ghostintranslation/motherboard/hardware/motherboard-1.WEBP

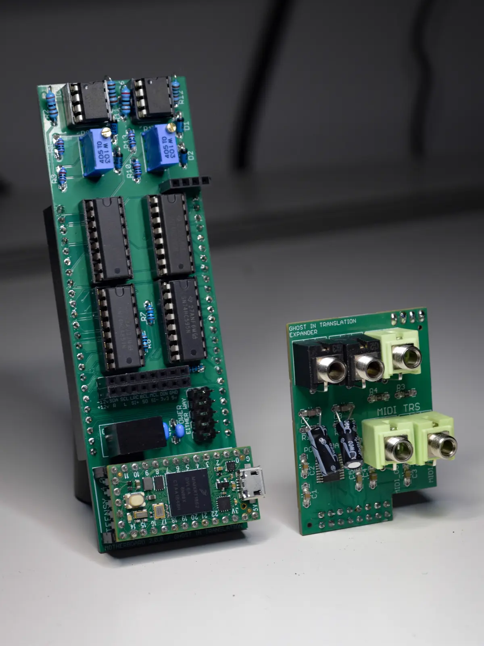
hardware/motherboard-1.WEBP
