ghostintranslation/motherboard/hardware/motherboard-2.WEBP

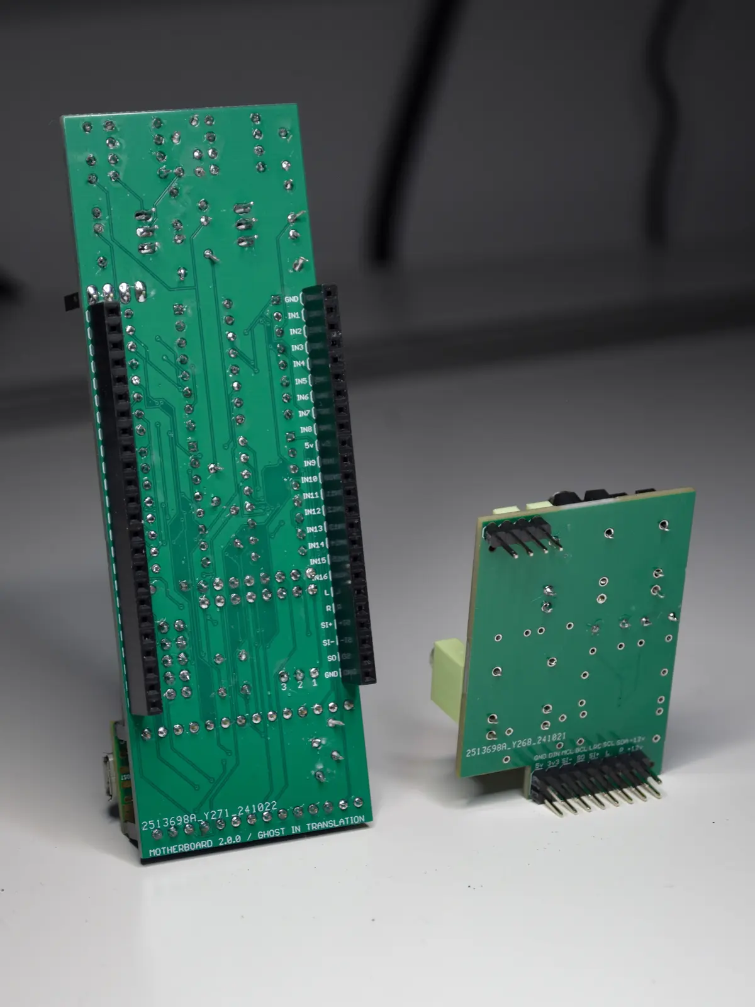
hardware/motherboard-2.WEBP
