ghostintranslation/motherboard/hardware/One_1-0-0_schematic.png

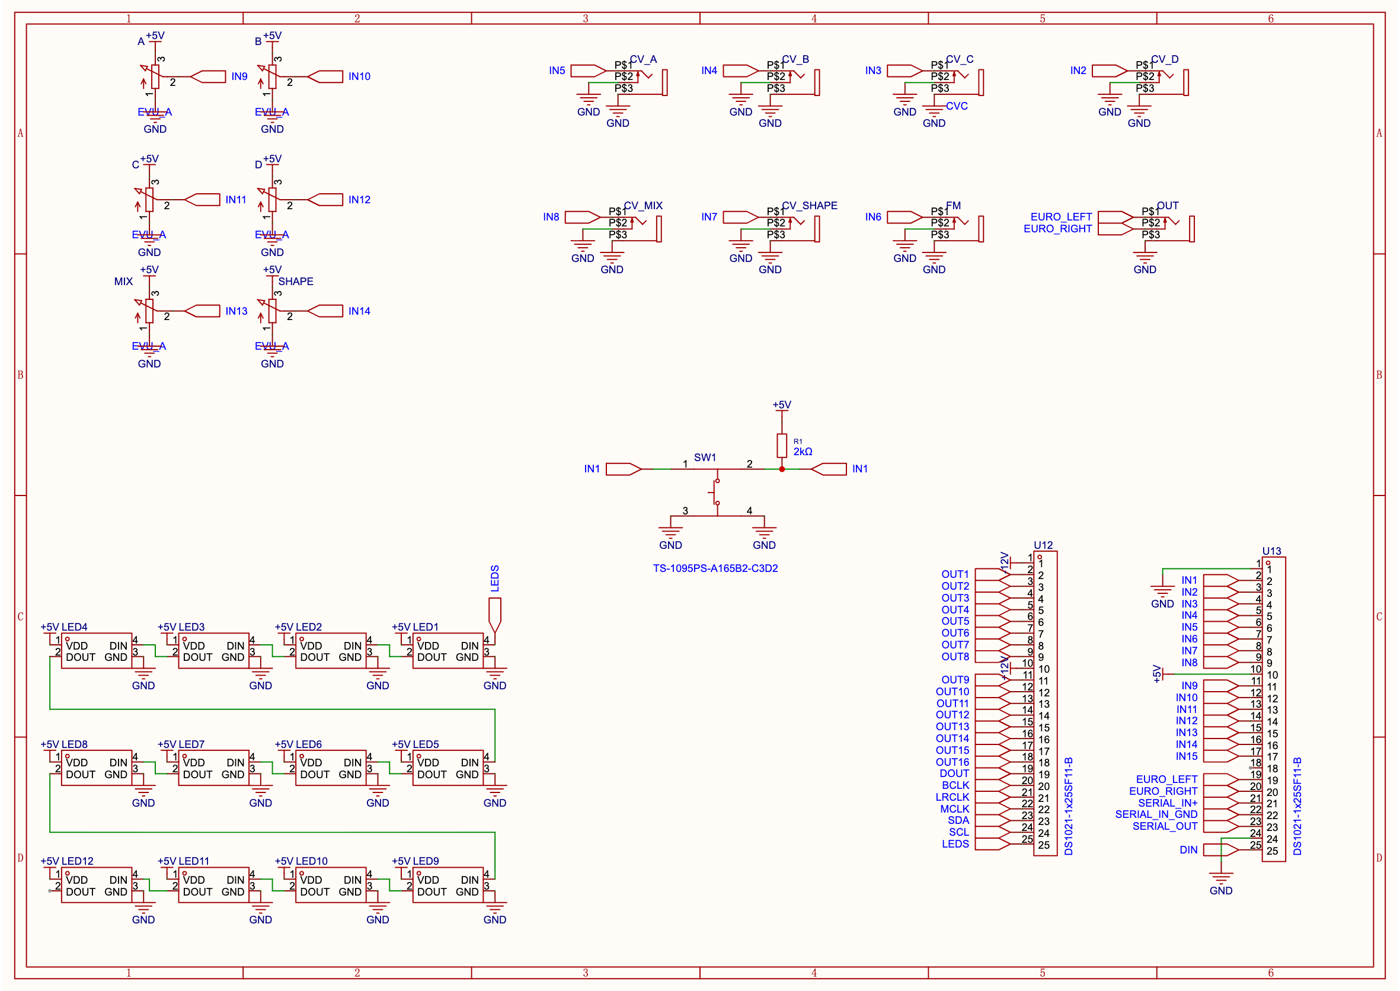
hardware/One_1-0-0_schematic.png
