ghostintranslation/motherboard/hardware/Mouser parts.xls

SHOPPING CART
This is not an invoice
01-Dec-24 20:28:49
 | Mouser # | Mfr. # | Manufacturer | Customer # | Description | RoHS | Lifecycle | Order Qty. | Price (CAD) | Ext.: (CAD)
1 | 595-SN74HC4851N | SN74HC4851N | Texas Instruments |  | Multiplexer Switch ICs 8-Ch Analog Mltplxr/Demltplxr | RoHS Compliant |  | 2 | $0.812 | $1.62
2 | 595-SN74HC595N | SN74HC595N | Texas Instruments |  | Counter Shift Registers Tri-State 8-Bit | RoHS Compliant |  | 2 | $1.99 | $3.98
3 | 603-MFR-25FTE52-10K | MFR-25FTE52-10K | YAGEO |  | Metal Film Resistors - Through Hole 10 kOhms 250 mW 1% 5 0 PPM / C | RoHS Compliant |  | 4 | $0.145 | $0.58
4 | 603-MFR25SFTF52-2K7 | MFR25SFTF52-2K7 | YAGEO |  | Metal Film Resistors - Through Hole | RoHS Compliant |  | 2 | $0.145 | $0.29
5 | 603-MFR-25FTF52-2K | MFR-25FTF52-2K | YAGEO |  | Metal Film Resistors - Through Hole 2Kohm 1% 1/4W Metal Film Resistor | RoHS Compliant |  | 3 | $0.145 | $0.44
6 | 603-MFR-12FRF521K | MFR-12FRF52-1K | YAGEO |  | Metal Film Resistors - Through Hole 1K OHM 1% 100PPM | RoHS Compliant |  | 2 | $0.145 | $0.29
7 | 603-MFR-25FRF52-158R | MFR-25FRF52-158R | YAGEO |  | Metal Film Resistors - Through Hole 158 OHM 1/4W 1% | RoHS Compliant |  | 1 | $0.145 | $0.15
8 | 81-PV36W103C01B00 | PV36W103C01B00 | Bourns |  | Trimmer Resistors - Through Hole 10Kohms 10mm Square 25turn | RoHS Compliant |  | 2 | $2.60 | $5.20
9 | 511-BAT43 | BAT43 | STMicroelectronics |  | Schottky Diodes & Rectifiers 200mA 30 Volt | RoHS Compliant By Exemption |  | 4 | $0.261 | $1.04
10 | 512-1N4148 | 1N4148 | onsemi |  | Small Signal Switching Diodes 100V Io/200mA BULK | RoHS Compliant By Exemption |  | 1 | $0.145 | $0.15
11 | 579-MCP6292-E/P | MCP6292-E/P | Microchip |  | Operational Amplifiers - Op Amps Dual 10MHz | RoHS Compliant |  | 2 | $1.84 | $3.68
12 | 859-6N137 | 6N137 | Lite-On |  | High Speed Optocouplers High Speed 10MBd LogicGate Output | RoHS Compliant |  | 1 | $1.31 | $1.31
13 | 512-MB1S | MB1S | onsemi |  | Bridge Rectifiers 0.5A Bridge | RoHS Compliant By Exemption |  | 1 | $0.696 | $0.70
14 | 490-VX7805-500 | VX7805-500 | CUI Inc. |  | Non-Isolated DC/DC Converters The factory is currently not accepting orders for this product. | RoHS Compliant | End of Life | 1 | $4.06 | $4.06
15 | 810-FG28X5R1E106MR06 | FG28X5R1E106MRT06 | TDK |  | Multilayer Ceramic Capacitors MLCC - Leaded RAD 25V 10uF X5R 20% LS:5mm | RoHS Compliant |  | 1 | $0.725 | $0.73
16 | 581-TAP226K010CCS | TAP226K010CCS | KYOCERA AVX |  | Tantalum Capacitors - Solid Leaded 10V 22uF 10% ESR=2.7 Ohm | RoHS Compliant |  | 1 | $0.957 | $0.96
17 | 200-SSW12401TS | SSW-124-01-T-S | Samtec |  | Headers & Wire Housings Tiger Buy Socket Strip with PCB Tails, .100" Pitch | RoHS Compliant |  | 2 | $3.94 | $7.88
18 | 200-SSW11402TS | SSW-114-02-T-S | Samtec |  | Headers & Wire Housings Tiger Buy Socket Strip with PCB Tails, .100" Pitch | RoHS Compliant |  | 2 | $2.38 | $4.76
19 | 200-SSW10802TS | SSW-108-02-T-S | Samtec |  | Headers & Wire Housings Tiger Buy Socket Strip with PCB Tails, .100" Pitch | RoHS Compliant |  | 2 | $1.39 | $2.78
20 | 200-SSW10401TMS | SSW-104-01-TM-S | Samtec |  | Headers & Wire Housings Tiger Buy Socket Strip with PCB Tails, .100" Pitch | RoHS Compliant |  | 1 | $1.06 | $1.06
21 | 523-G800W303018EU | G800W303018EU | Amphenol |  | Headers & Wire Housings Pin Header 2.54mm Pitch STR DIP,1x5Pin,FULL G/F,NY6T,6.1mm*2.5mm*3.0mm,Color-Black,BAG | RoHS Compliant |  | 2 | $0.174 | $0.35
22 | 571-1-2199298-4 | 1-2199298-4 | TE Connectivity |  | IC & Component Sockets 16P DIP SKT 300 CL LADDER | RoHS Compliant |  | 2 | $0.363 | $0.73
23 | 571-1-2199298-2 | 1-2199298-2 | TE Connectivity |  | IC & Component Sockets 8P DIP SKT 300 CL LADDER | Not Applicable |  | 2 | $0.305 | $0.61
By submitting your order you agree to these terms and conditions. (https://www.mouser.ca/saleterms) |  |  |  |  |  |  |  |  | Merchandise: | $43.35
Prices are reflected at the date and time shown. |  |  |  |  |  |  |  |  | Shipping Charge: | $20.00
