ghostintranslation/motherboard/hardware/Expander 1.0.4.pdf

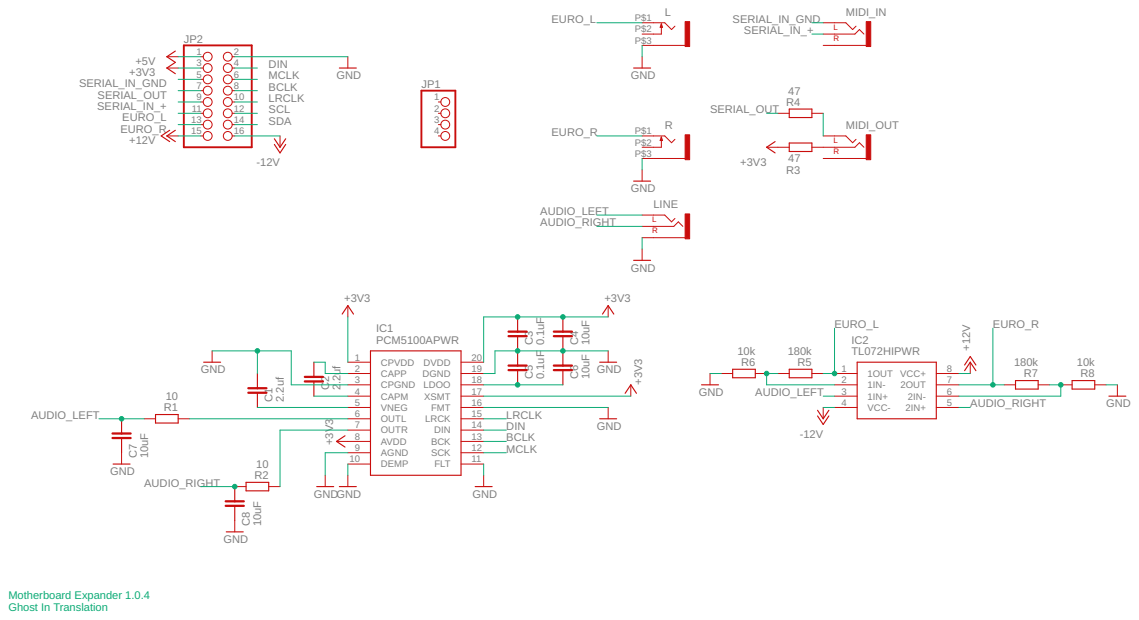
[picture p4: page 1]
