ghostintranslation/motherboard/hardware/Expander 1.0.3.pdf

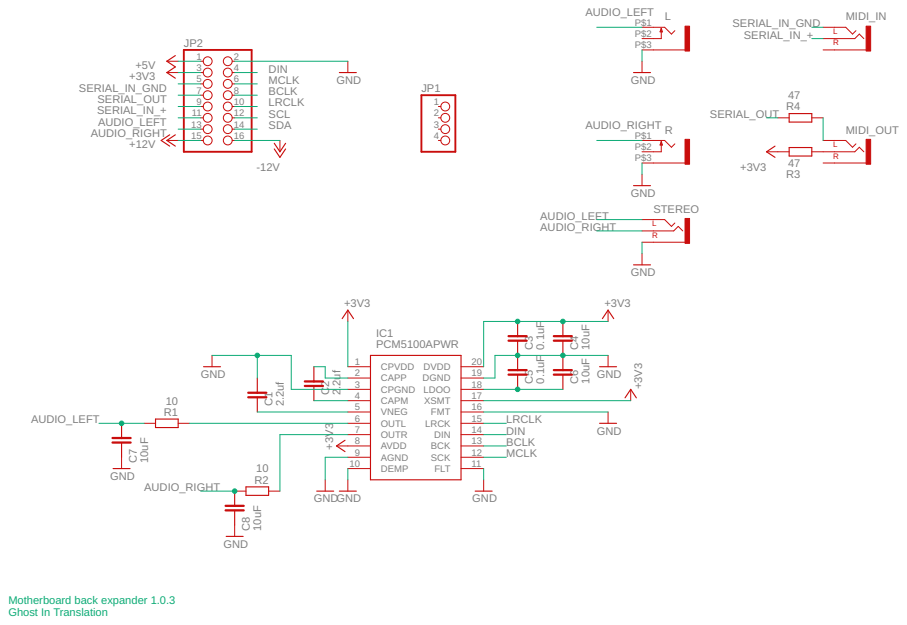
[picture p5: page 1]
