ghostintranslation/motherboard/hardware/Schematics.pdf

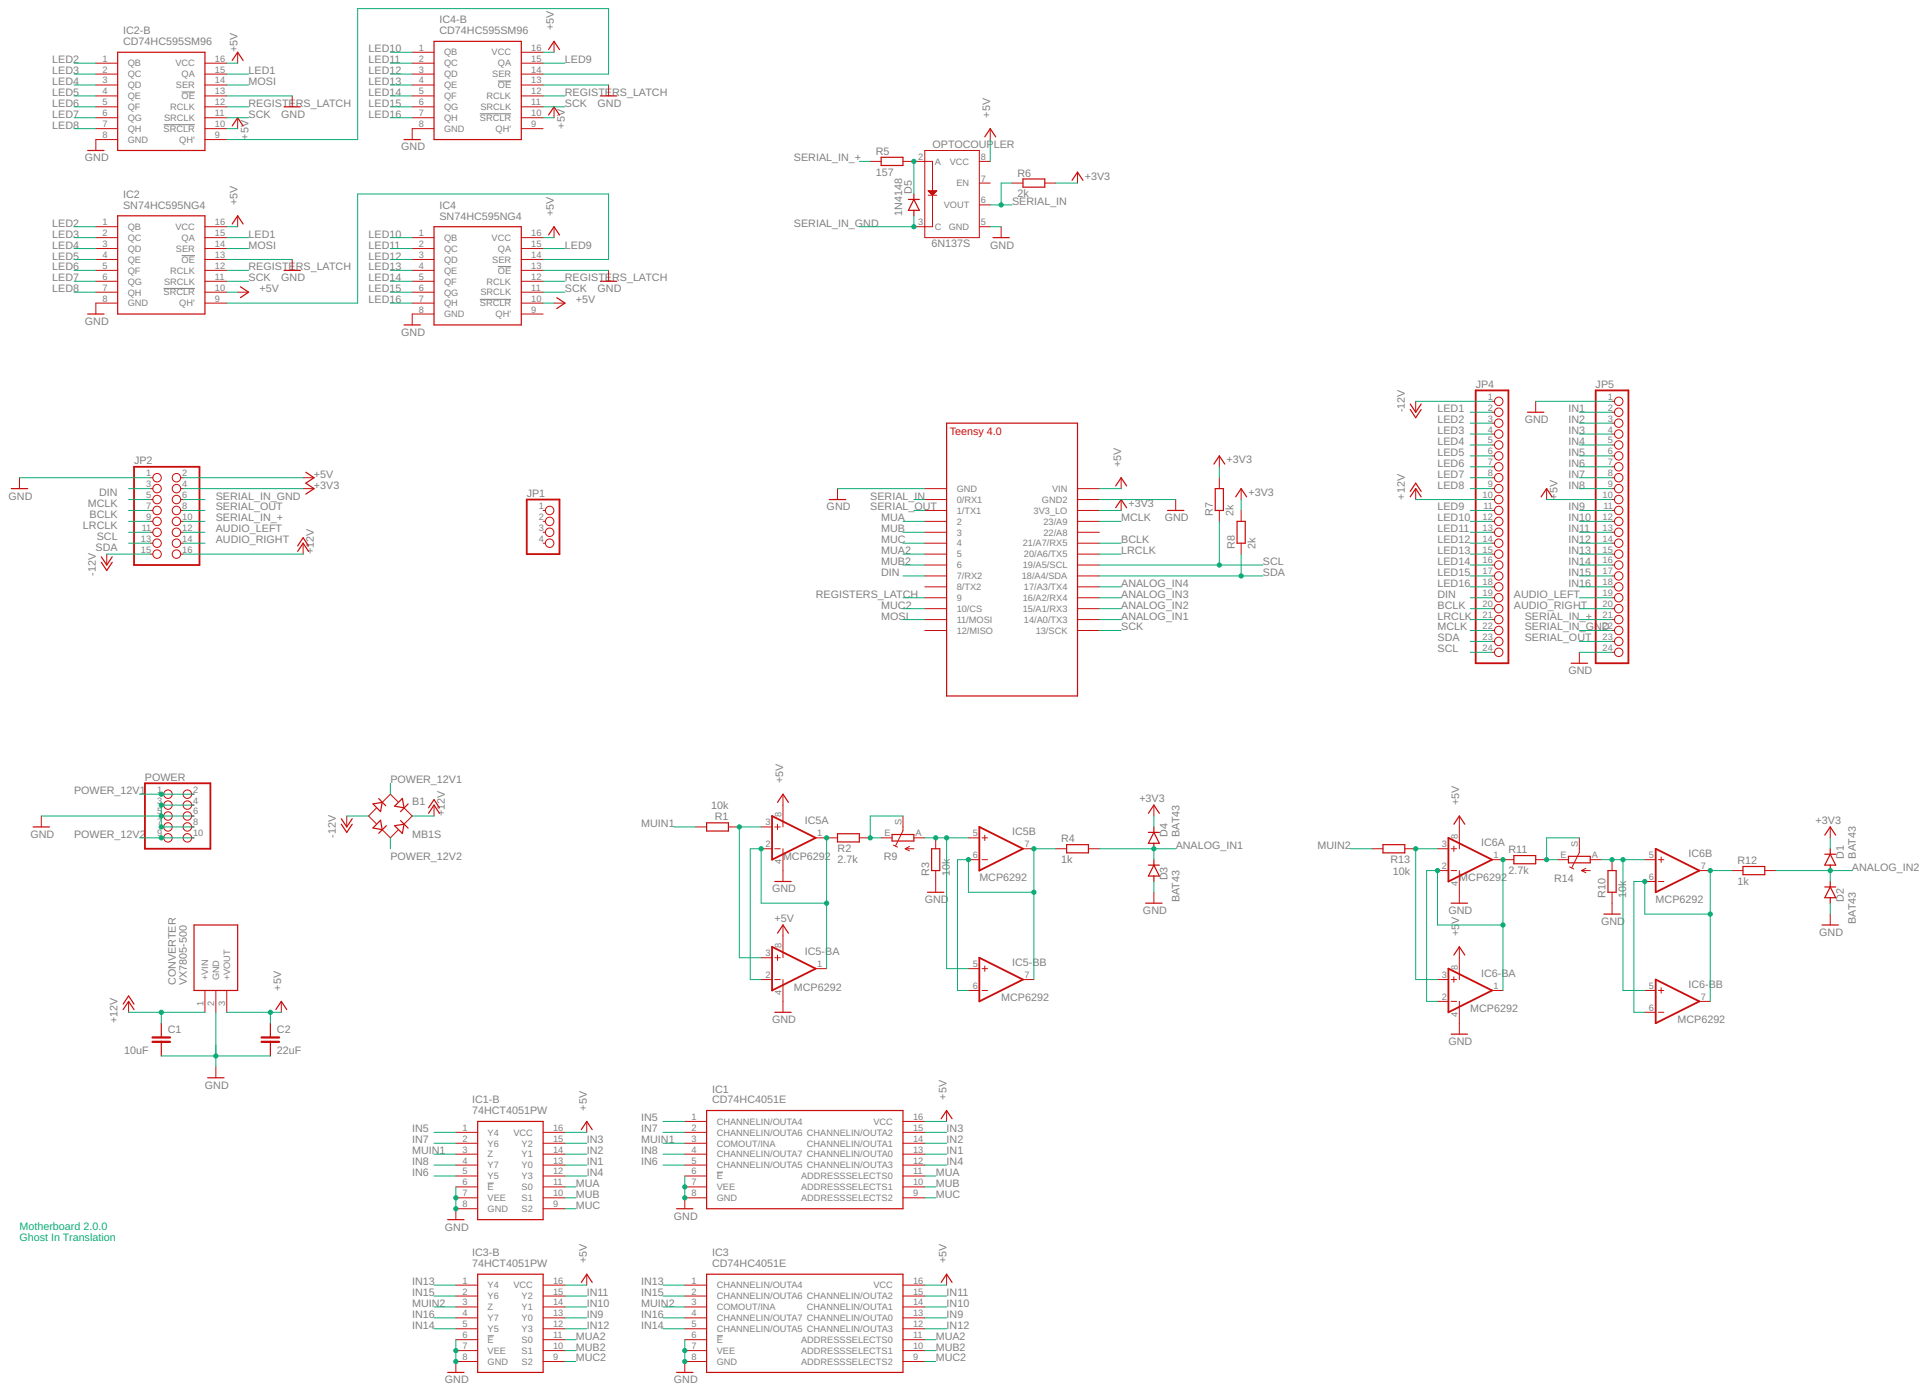
[picture p6: page 1]

Motherboard 2.0.0 Ghost In Translation
