ghostintranslation/motherboard/(threads)

Thread 2 (2023-10-04):

Order PCB

dfeyer, 2023-10-04:
Hi, did you plan an other batch of PCB, i see that nothing is available to order from your website ? Or did you plan to make the PCB layout opensource ?

Bests, thanks for the amaizing work

ghostintranslation, 2023-10-05:
Hey, yes nothing is available at the moment because I am still working on the new version of the main board, then I will be selling the PCB and panels as I was before with the first version. So the first version is not going to be available anymore to focus only on v2.

dfeyer, 2023-10-23:
Thanks for your work

ghostintranslation, 2024-08-10:
Hey, so you know, the project enters a beta testing phase, so hopefully v2 is available soon.

ghostintranslation, 2025-02-24:
Closing as v2 is now available, checkout my website: https://www.ghostintranslation.com/

Closed 2025-02-24.
