ghostintranslation/motherboard/(commit log)

2021-05-01 Fixed rotary encoder callback not passing the right direction
    [Motherboard.h]
2021-07-30 WIP making progress, inputs and leds seems to work
2021-08-02 WIP - Added RotaryEncoder logic - Added individual print method to inputs and outputs
2021-12-06 WIP now LEDs status work again
2021-12-07 WIP - Added lowpass filter to potentiometer - Added MIDI to all IO - Potentiometer with MIDI acts like an attenuator so there is no conflict
2021-12-09 WIP Added calibration
2021-12-10 Added calibration using State pattern to be able to have different logic according to state
2021-12-20 - Updated callbacks to use IO pointer - Removed namespace - Added InputTouchpad - Added IOTypeQuantized - Reduced SPI calls -
2023-12-02 Initial commit of the current v2
2023-12-03 Added schematics and example
2023-12-03 Added BOM
2023-12-24 Converted the Led class to a general Output class and this one implements a sigma-delta algorithm instead of pwm
2023-12-29 - Fixed outputs not working when not connected to another audio object - Fixed smoothing not working
    [SimpleLeds.ino]
2024-01-08 Added inputs of type Button and Rotary with callbacks
2024-01-16 Improved inputs of type rotary encoder
2024-06-21 Fix input range issues, and removed comments
    [Input.h, SimpleLeds.ino]
2024-07-05 Writing documentation
    [BOM.csv]
2024-07-15 Reworked the simple led example
    [SimpleLeds.ino]
2024-07-30 Rotary encoders fix and example
    [Rotary.ino]
2024-08-09 Added note about decoupling capacitor on the beta version of the expander
2024-08-14 - Added Settings example - Added ability to pass a MidiInput to a Input - Added MidiNoteInput and MidiCCInput - Removed debug prints
2024-09-05 Added calibration helper program
2024-11-13 Fixed calibration example
2024-11-23 Increased default filtering on inputs
2024-11-23 Updated schematics and readme to the latest revision
    [BOM.csv]
2024-12-14 Improved documentation
    [BOM.csv, Mouser parts.xls]
2025-01-29 Added Expander schematics
2025-02-28 Added calibration helper
2025-03-05 Added schematics of latest expander
2026-10-09 WIP new v3 with Pico 2
